yiyu9511/r3-car-mechanical/docs/C30D集成板安装说明.md

# C30D 集成控制板安装说明（电控新方案）

> 更新：2026-11-03。当前电控为 **WHEELTEC C30D 驱控一体板**（实物 V2.3）。
> 模型源文件位于 `models/`，已定位装配位于 `assemblies/`。C30D 属于第一层；第二层放 CAT、雷达和相机。

---

## 1. 模型清单（全部在仓库，不要再用外部路径）

| 零件 | 仓库内文件 | 说明 |
|---|---|---|
| R3 mini 底盘 | `models/R3mini四驱小车底盘（无悬挂）_utf8.stp` | 不动 |
| **C30D 控制板** | `models/C30D-V2.2_2026.04.20.stp` | ★新入库。实物是 V2.3；官方说明 V2.2→V2.3 仅电源电路与 USB 口 TVS 防护差异，**外形尺寸、安装孔完全相同** |
| 鲁班猫 5（上位机） | `models/LubanCat 5-PCB 3D文件.STEP`、`models/LubanCat 5-外壳3D文件-20240911.STEP` | 位于第二层，见 `docs/当前设计.md` |
| **装配验证参考** | `assemblies/c30d_on_chassis.FCStd` | 实际 6 mm 铜柱，四孔中心最大偏差约 **0.00013 mm**；模型几何结果，实物公差未验证 |

## 2. 安装定位（核心结论）

- **安装位 = 底盘中部"树莓派孔组" 58×49mm**（C30D 角孔孔距同为 58×49，四角直接对齐）
- 底盘四角孔坐标（原点=底板中心 Ø20 大孔，**+Y = 车头方向**）：

| 角 | X (mm) | Y (mm) | 底盘模型孔径 |
|---|---|---|---|
| 左后 | -21.04553 | -29.79255 | Ø2.6 |
| 右后 | 36.95447 | -29.79255 | Ø2.6 |
| 左前 | -21.04553 | 19.20745 | Ø2.6 |
| 右前 | 36.95447 | 19.20745 | **Ø3.2** |

- **五金**：M2.5 铜柱 ×4 + M2.5 螺母 + 垫片（C30D 孔为 D3.0，穿 M2.5 螺杆有 0.5mm 间隙，垫片压紧即可）
- **垫高**：当前模型为 6 mm。底板顶面 Z=1.5、PCB 底面 Z=7.5；最低板底元件距底板约 2.3 mm。
- **方向**：验证装配为 0°（模型坐标与底盘同向，**无需旋转**）。若电机走线不顺，可整板转 180°——58×49 矩形中心对称，孔位仍对齐

## 3. FreeCAD 复现步骤（装配同事按此操作）

1. 新建文档，导入 `models/R3mini四驱小车底盘（无悬挂）_utf8.stp`
2. 导入 `models/C30D-V2.2_2026.04.20.stp`
3. 选中 C30D 零件 → 属性 **Placement → Position**：
   - **X = 29.181653，Y = -11.520388，Z = 7.5**。源模型的 PCB 底面为局部 Z=0；铜柱高度为 H 时，**Z = H + 1.5**。
   - Rotation 保持 0
4. 验证：俯视四角孔同心；执行干涉检查，C30D 与底板/轮组无碰撞
5. 对照件：打开 `assemblies/c30d_on_chassis.FCStd`。修改 `Params.standoff_h` 可同时驱动板卡与铜柱高度。

> 生成脚本：`tools/build_current_baseline.py`。报告：`output/current/baseline_checks.json`，包括参数变更和保存后读回校验。

## 4. 电气接线（装配时按此预留走线与开口）

| 连接 | 说明 |
|---|---|
| 电源输入 | 12V 电池 → 电源口（红正黑负，**≤17V，禁反接**） |
| 电机 ×4 | **实车现行接法：A口=右后、B口=左后、C口=左前、D口=右前**。⚠️与官方接线图不同——固件已做端口重映射匹配此接法，**就按此接，不要按官方图改** |
| 串口3（Type-C） | → 鲁班猫 5 USB（ROS 通信，115200） |
| 串口1（Type-C） | 烧录/调试口，留在手能够到的位置 |
| Type-C 5V 供电口 | → 鲁班猫 5 供电（与舵机共 5V/3A 预算） |
| SWD 调试（H2 排针左上 2×2） | pin20=3V3、pin18=GND、pin16=SWDIO(PA13)、pin14=SWCLK(PA14) |
| 使能开关 | 保持可触及（电机总开关，断开则 PWM 归零） |

## 5. 板载功能

C30D 单板集成：STM32F407VET6 主控 + 4×AT8236 电机驱动（单路 ≤1.3A）+ 板载 5V/3A、3.3V 电源（替代稳压模块）+ 4 路编码器接口 + ICM20948 陀螺仪 + OLED + CAN。三件套的功能全部被覆盖，接线大幅减少。

## 6. 安全注意

- 板子**不得直接放金属面**；使用 M2.5 铜柱、合适垫片固定，避免铜柱或紧固件接触非安装区电路。
- 上电前核对电源极性；触碰板子前释放静电
- 电机禁止长时间堵转（单路 ≤1.3A，4 路总 ≤5A）

---

*接线参考：`docs/ref/C30D_V2.3_H2.png`、`docs/ref/C30D_V2.3_SWD.png`。机械复核：`output/current/baseline_checks.json`。*
