yiyu9511/r3-car-mechanical/docs/ref/C30D_V2.3_H2.png

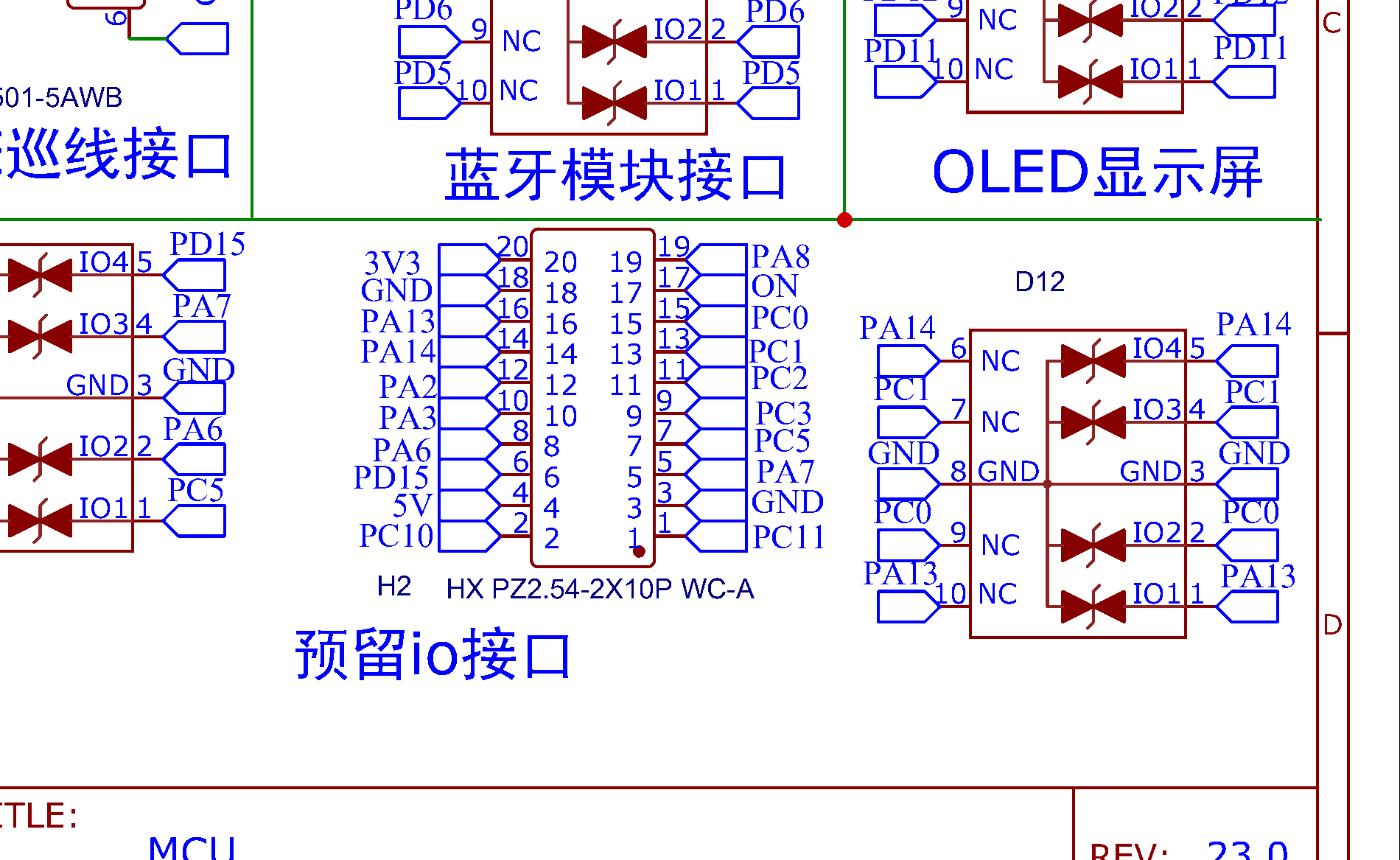
docs/ref/C30D_V2.3_H2.png
