yiyu9511/r3-car-mechanical/docs/ref/C30D_V2.3_SWD.png

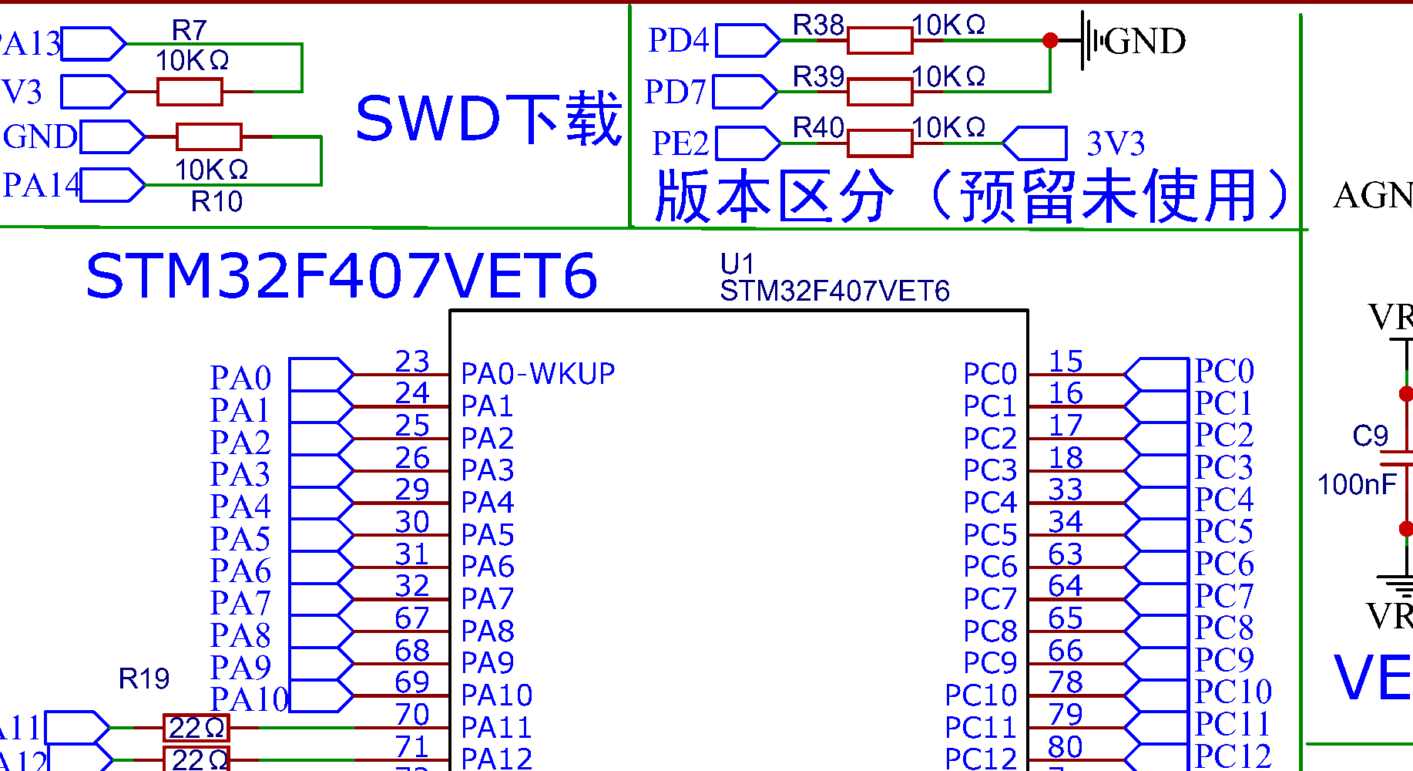
docs/ref/C30D_V2.3_SWD.png
