yiyu9511/r3-car-mechanical/docs/ref/IMX415_V1R1_尺寸图.png

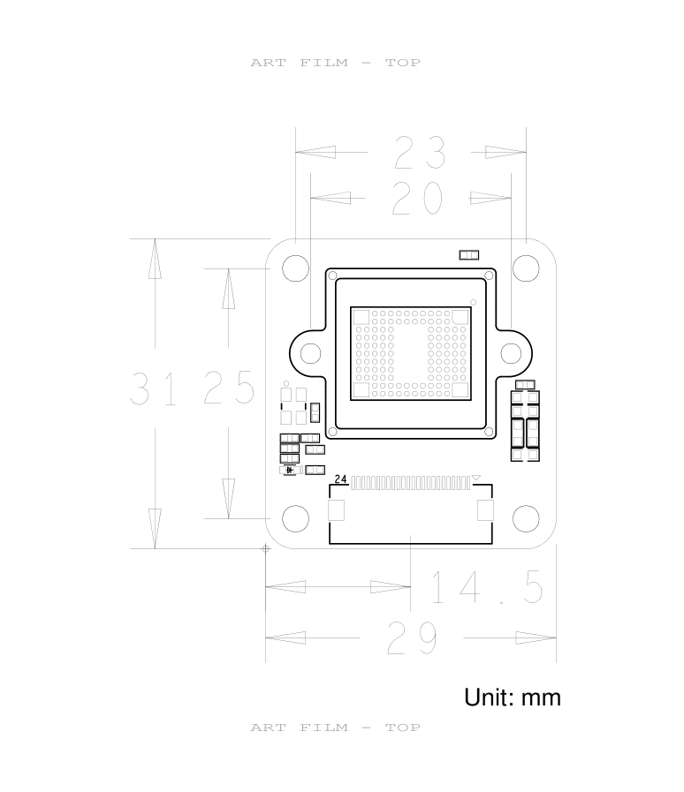
docs/ref/IMX415_V1R1_尺寸图.png
