yiyu9511/r3-car-mechanical/output/current/c30d_on_chassis_iso.png

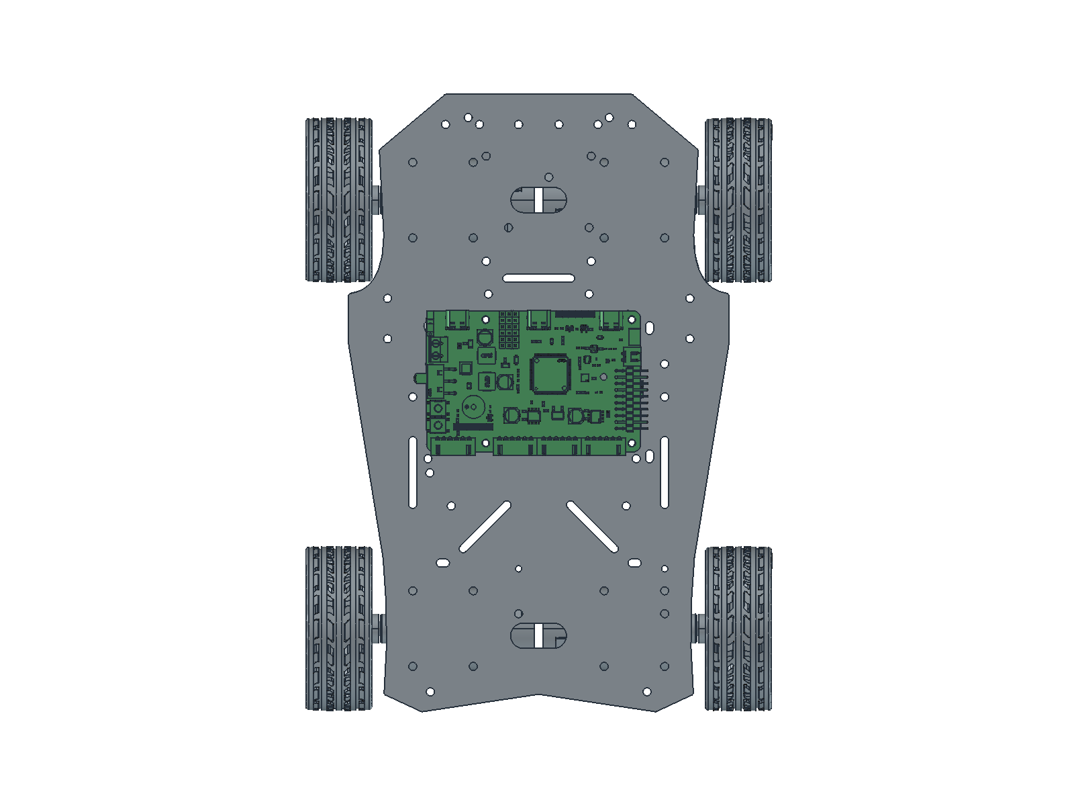
output/current/c30d_on_chassis_iso.png
