yiyu9511/r3-car-mechanical/output/two_layer/cat_mount_underside.png

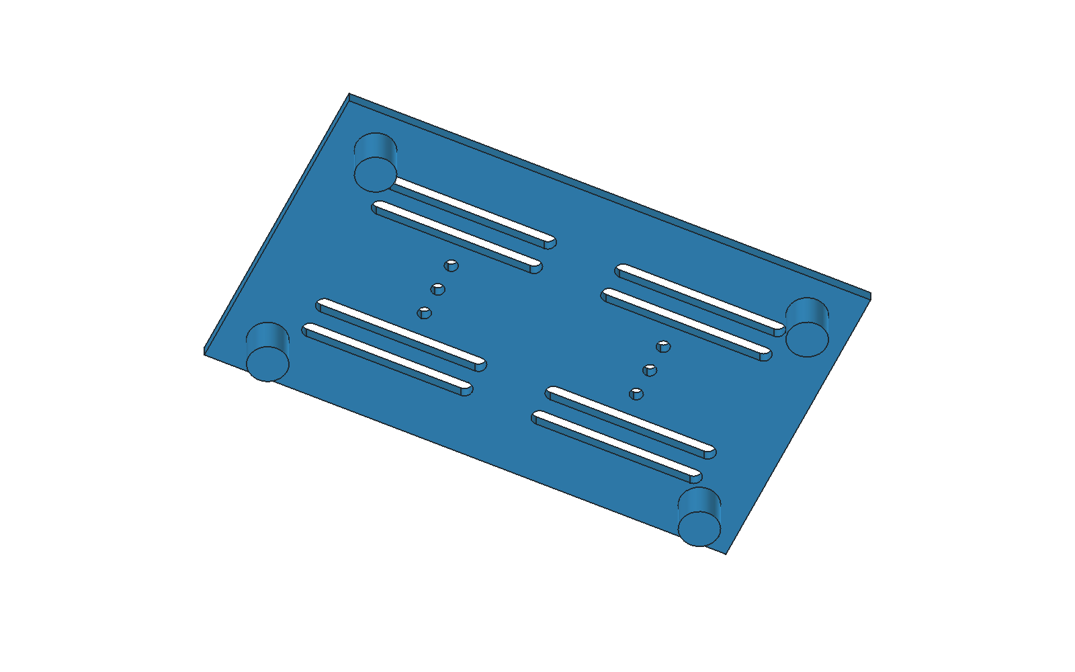
output/two_layer/cat_mount_underside.png
