yiyu9511/r3-car-mechanical/output/two_layer/exploded_iso.png

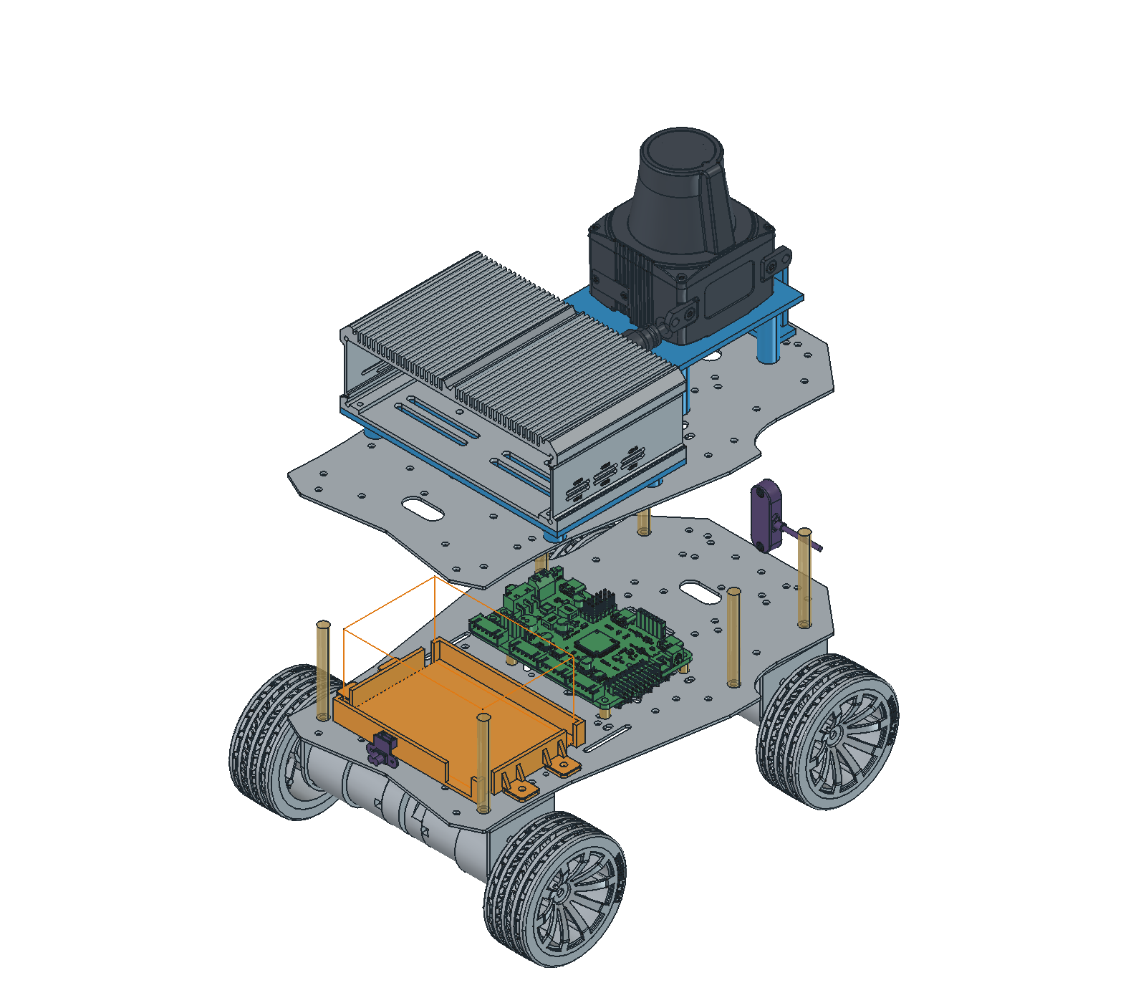
output/two_layer/exploded_iso.png
