yiyu9511/r3-car-mechanical/output/two_layer/layer1_top.png

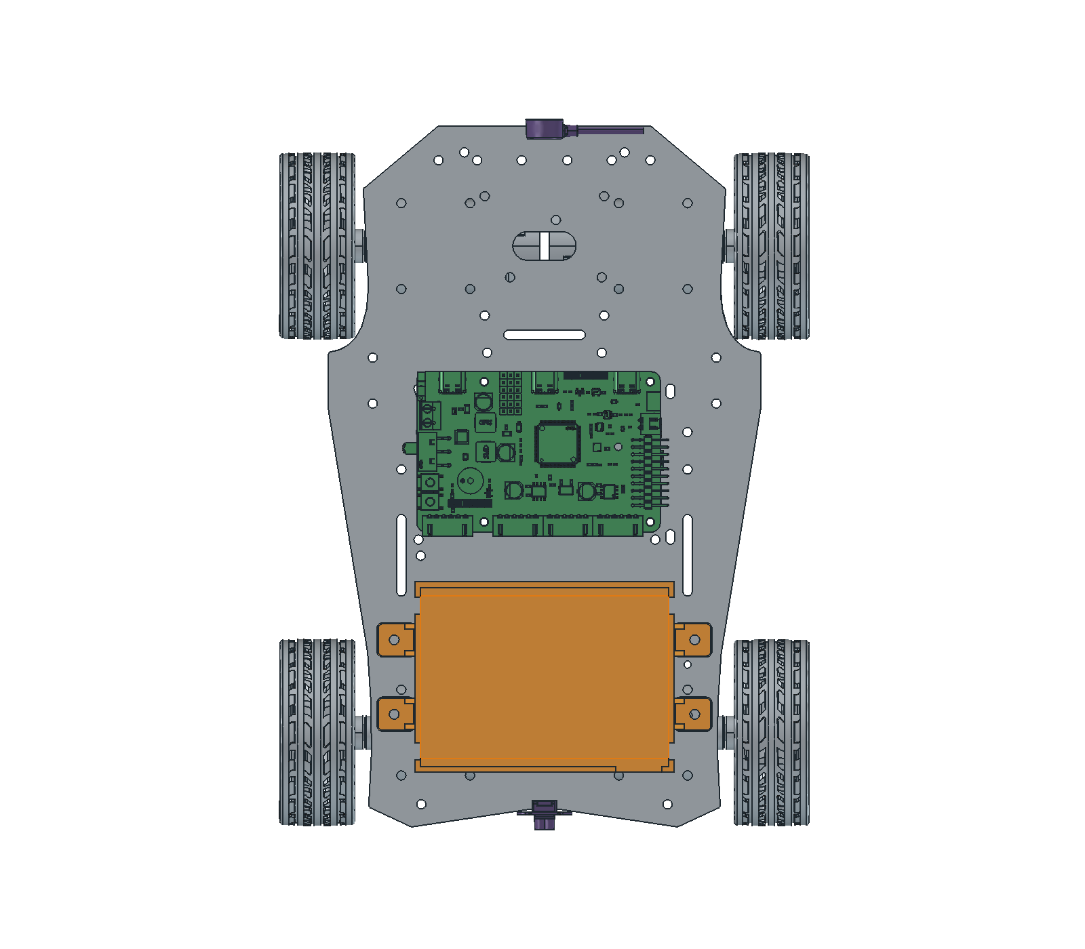
output/two_layer/layer1_top.png
