yiyu9511/r3-car-mechanical/output/two_layer/layer2_top.png

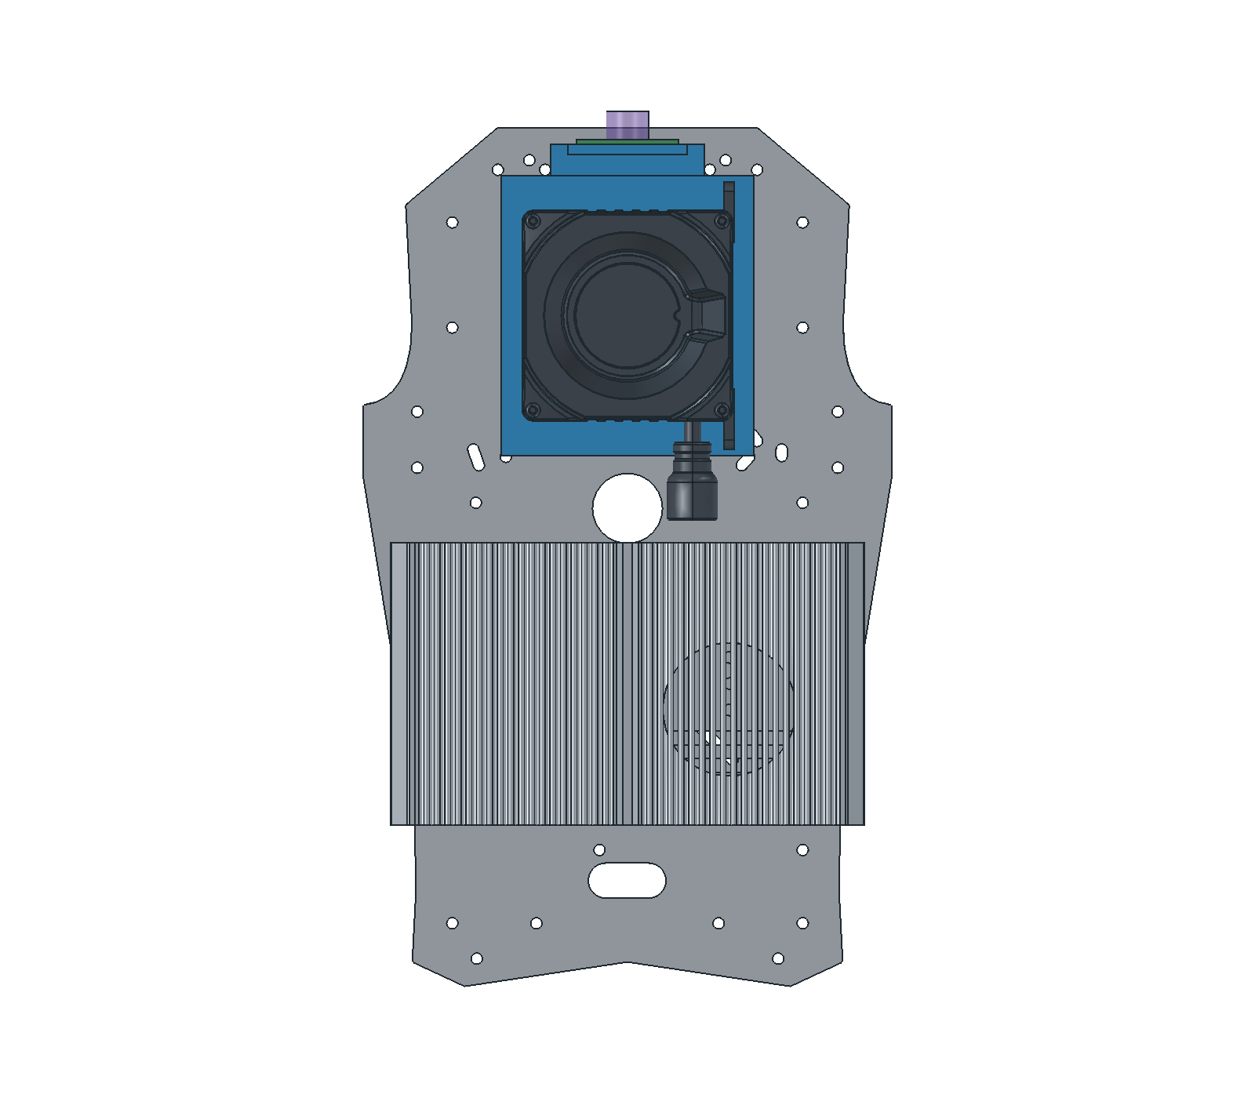
output/two_layer/layer2_top.png
