yiyu9511/r3-car-mechanical/output/two_layer/overview.png

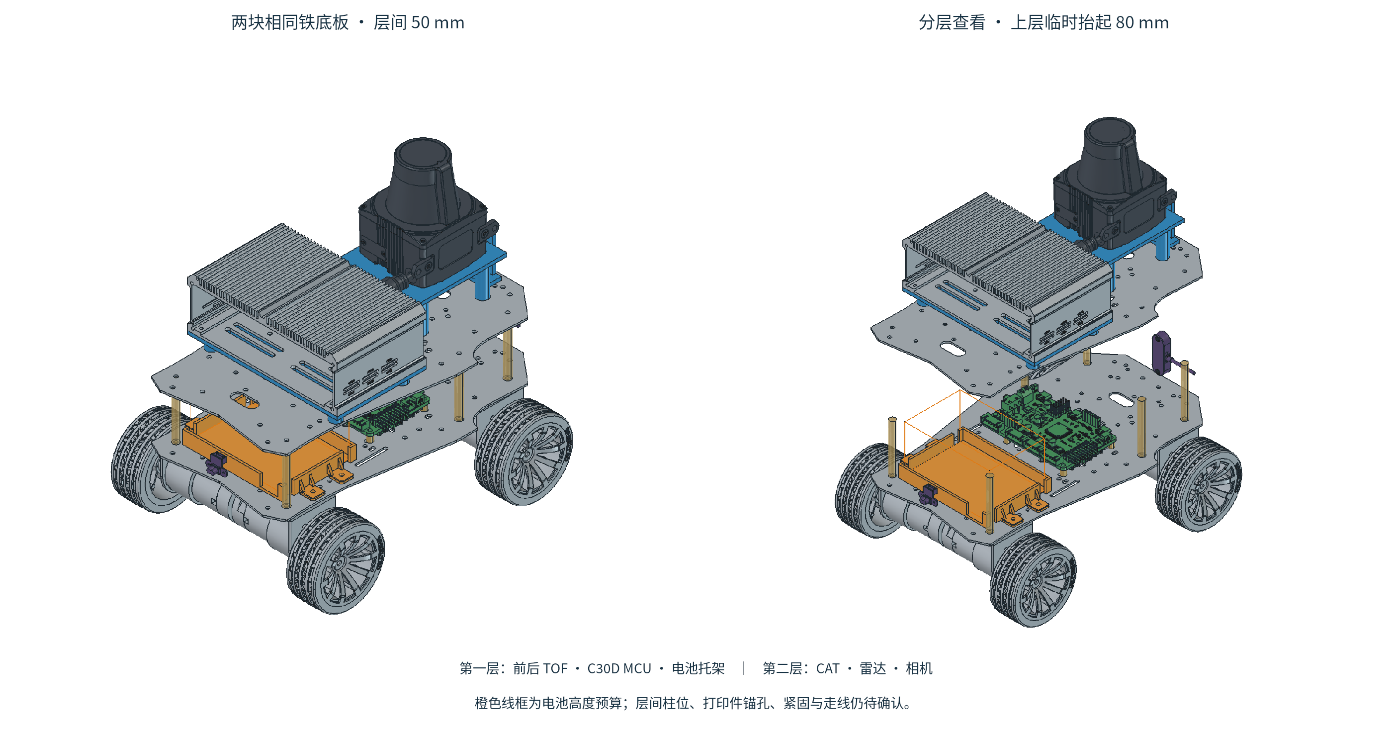
output/two_layer/overview.png
