yiyu9511/r3-car-mechanical/assemblies/c30d_on_chassis.FCStd

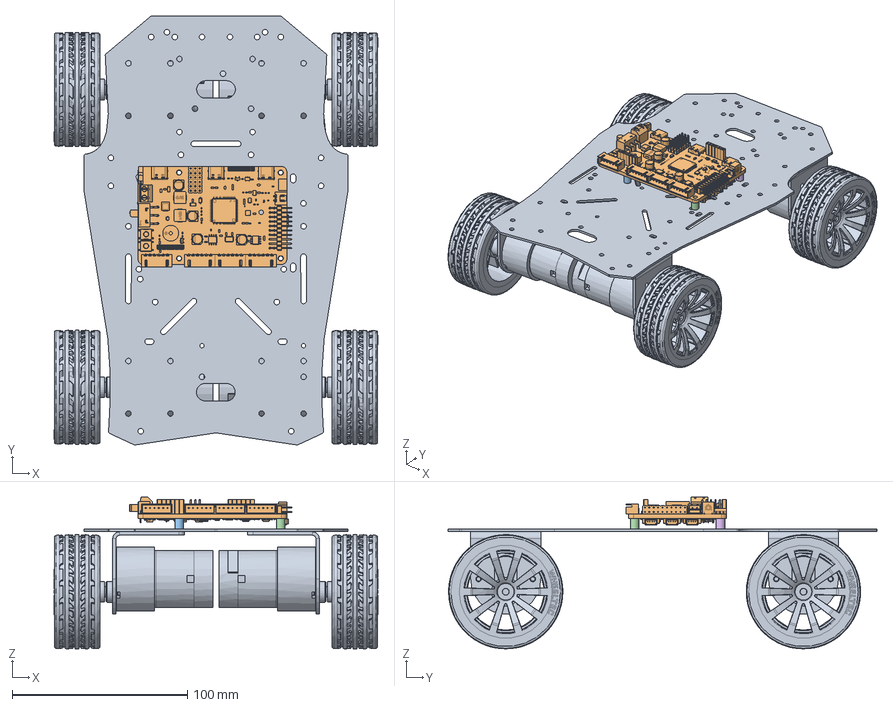
[picture p10: CAD file, 2026-11-03]
assemblies/c30d_on_chassis.FCStd
185.0 x 245.0 x 86.7 mm
R3 mini 底盘
C30D V2.3（使用 V2.2 外形参考）
M2.5×6 铜柱示意 1
M2.5×6 铜柱示意 2
M2.5×6 铜柱示意 3
M2.5×6 铜柱示意 4
