yiyu9511/r3-car-mechanical/models/电池托架参考.step

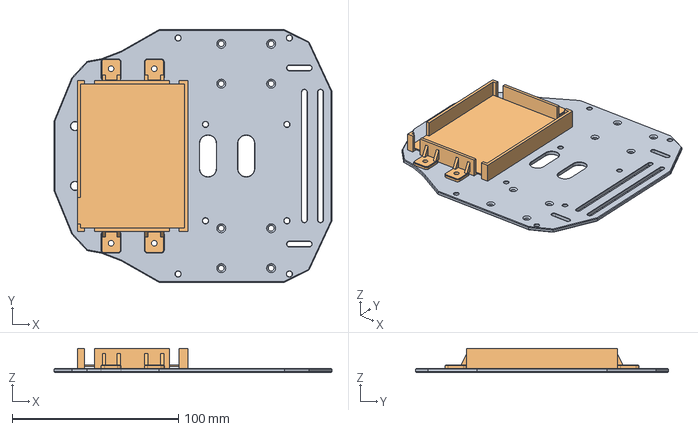
[picture p11: CAD file, 2026-11-03]
models/电池托架参考.step
167.3 x 152.0 x 14.5 mm
