yiyu9511/r3-car-mechanical/assemblies/two_layer.FCStd

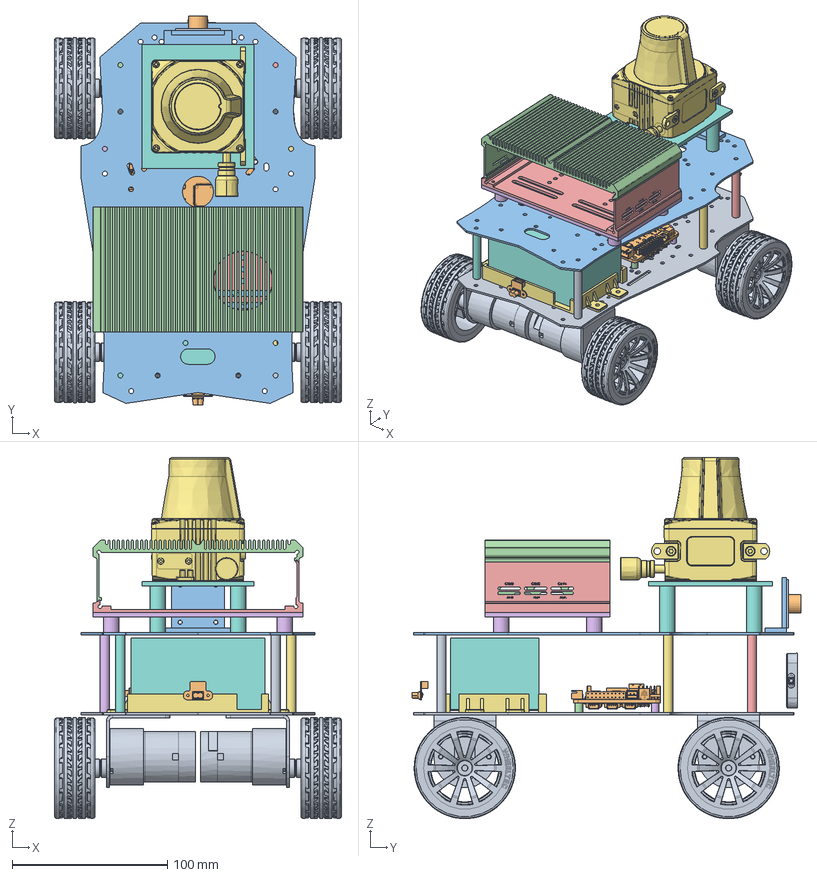
[picture p12: CAD file, 2026-11-03]
assemblies/two_layer.FCStd
185.0 x 250.6 x 232.9 mm
下层原有铁底盘及轮组
C30D MCU · 已确定 6 mm 垫高
MCU 铜柱
MCU 铜柱001
MCU 铜柱002
MCU 铜柱003
用户指定托架 · 内腔与夹持结构保留
电池高度预算框 · 非实物电池模型
TOF-M S 厂家模型
TOF-F2 厂家曲面参考 · 非闭合实体
第二块相同铁底板 · 原轮廓 / 原孔型
CAT 金属外壳
CAT 金属外壳001
CAT 贴壳托板 + 四个局部落脚 · 未开底盘锚孔
雷达机身与扫描头（原弯曲线缆另列）
雷达转接架占位 · 保持原机身 · 紧固与锚孔未定
IMX415 V1R1 板轮廓/孔位 · 厚度未实测
镜头包络占位 · 尺寸不是加工依据
相机支架概念 · 无铁板锚孔
层间铜柱候选 1（未确认可用孔）
层间铜柱候选 2（未确认可用孔）
层间铜柱候选 3（未确认可用孔）
层间铜柱候选 4（未确认可用孔）
层间铜柱候选 5（未确认可用孔）
层间铜柱候选 6（未确认可用孔）
