yiyu9511/r3-car-mechanical/models/C30D-V2.2_2026.04.20.stp

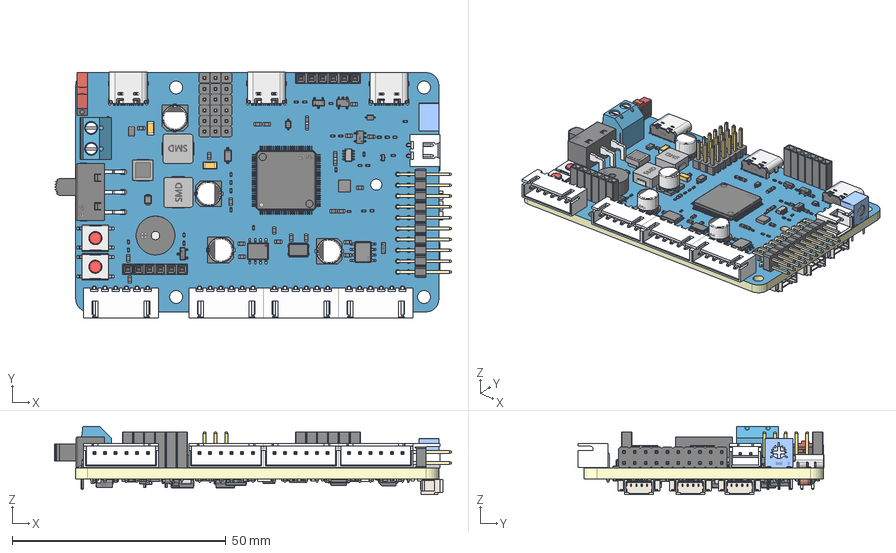
[picture p13: CAD file, 2026-11-03]
models/C30D-V2.2_2026.04.20.stp
92.9 x 57.5 x 16.0 mm
Board~zoGU_1
TopCopper~zoGU_1
BottomCopper~zoGU_1
TopFpcStiffener~zoGU_1
BottomFpcStiffener~zoGU_1
WDFN-5_L3.3-W3.3-P0.65-BL~WDFN-5_L3.3-W3.3-P0.65-BL~iKOY_1 x 2
C0603~0603~H7io_1 x 66
USON-10_L2.5-W1.0-P0.50-BL~USON-10_L2.5-W1.0-H0.6-P0.50~hjPK_1 x 11
CONN-SMD_GP01-1250WRS-4P~CONN-SMD_GP01-1250WRS-4P~h4bH_1 x 3
R0603~R0603~q9do_1 x 32
SOT-23-5_L3.0-W1.7-P0.95-LS2.8-BR~SOT-23-5_L3.0-W1.9-P0.95-BL~efmv_1
SOIC-8_L5.0-W4.0-P1.27-LS6.0-BL-EP~SOIC-8_L5.0-W4.0-P1.27-LS6.0-BL-EP~TPw5_1 x 2
4148~SOD-80C_L3.3-W1.5-H1.5-RD~f0Kv_1
SMB_L4.6-W3.6-LS5.3-RD~SMB_L4.6-W3.6-LS5.3-RD~4kkn_1 x 4
QFN-24_L4.0-W4.0-P0.50-BL-EP2.5~QFN-24_L4.0-W4.0-P0.50-BL-EP2.5~hbPG_1 x 2
R0603~R2512_L6.3-W3.2-H0.6~DNXC_1 x 2
R2512~R2512_L6.3-W3.2-H0.6~DNXC_1 x 2
C1206~C1206_L3.2-W1.6-H1.3~i1Ai_1 x 4
ESOP-8_L4.9-W3.9-P1.27-LS6.0-BL-EP~ESOP-8_L4.9-W3.9-P1.27-LS6.0-BL-EP-A~smAH_1 x 2
CONN-SMD_2.54-2PWT~CONN-SMD_2.54-2PWTB~Tr5w_1
SOT-23-3_L2.9-W1.6-P1.90-LS2.8-BR~SOT-23-3~imgh_1 x 3
ESOP-8_L4.9-W3.9-P1.27-LS6.0-BL-EP~ESOP-8_L4.9-W3.9-P1.27-LS6.0-BL-EP3.3~G8WZ_1 x 2
SOIC-8_L4.9-W3.9-P1.27-LS6.0-BL~SOIC-8_L4.9-W3.9-P1.27-LS6.0-BL-EP-1~XG5v_1
SOD-123_L2.7-W1.6-LS3.7-RD~SOD-123_L2.7-W1.6-LS3.7-RD-1~rkkE_1
SOD-123FL_L2.7-W1.8-LS3.8-RD~SOD-123FL_L2.7-W1.8-LS3.8-RD-1~IUjj_1 x 2
L0805~L0805_L2.0-W1.3-H0.9~AZev_1
SOT-23-5_L3.0-W1.7-P0.95-LS2.8-BR~SOT-23-5_L2.9-W1.6-P0.95-LS2.8-BL~JfRL_1 x 3
SMB_L4.3-W3.6-LS5.3-RD~SMB_L4.3-W3.6-LS5.4-R-RD~8GdQ_1
FILTER-SMD_4P-L5.0-W4.8-TL~FILTER-SMD_4P-L5.0-W4.8-TL~e4g5_1
SOT-23_L2.9-W1.3-P1.90-LS2.4-BR~SOT-23_L2.9-W1.3-P1.90-LS2.4-BR-1~AAka_1_1
HDR-TH_2P-P2.50_XY-XH2.54-2A21~HDR-TH_2P-P2.50_XY-XH2.54-2A21~xBt2_1
2_10P弯排针~HDR-TH_PZ254R-12-20P-RD~Effy_1
KEY-SMD_4P-L6.2-W6.2-P4.00-LS6.8~KEY-SMD_4P-L6.0-W6.0-P4.50-LS8.6_TS6625A4P~JGtd_1 x 2
ICM20948-QFN-24~QFN-24_L2.8-W2.8-BMS003~Jafe_1
F0805~F0805_L2.1-W1.4-H0.8~WA51_1
HDR-M-2.54_1X3~HDR-M-2.54_1x3~QQ3y_1 x 6
CONN-TH_6P-P2.50_B6B-XH-A-LF-SN~HDR-F-2.54_1x6~mopP_1 x 2
IND-SMD_L7.3-W6.8~IND-SMD_L7.3-W6.8-H3.0~fGpv_1 x 2
SOT-23-8_L3.0-W1.7-P0.65-LS2.8-BL~TSOT-23-8_L2.9-W1.6-P0.65-LS2.8-TL~tMWu_1
CAP-SMD_BD6.3-L6.6-W6.6-RD~CAP-SMD_BD6.3-L6.6-W6.6-FD_EFVM063ADA220M0640~GzIP_1 x 4
OSC-SMD_L5.0-W3.2~OSC-SMD_L5.0-W3.2-H1.4~kKbf_1
USB-C-SMD_TYPE-C-USB-17~USB-C-SMD_TYPE-C-USB-17~E8VL_1 x 3
RES-ADJ-TH_3362S~RES-ADJ-TH_3362S~l5SZ_1
CONN-TH_6P-P2.50_X8821WR-06S-N2SN~CONN-TH_6P-P2.50_X8821WR-06S-N2SN~kmu8_1 x 4
SW-TH_BSI-10~SW-TH_BSI-10-L10.0-W2.5-H6.4-P2.54~bBl8_1
SOD-323_L1.8-W1.3-LS2.5-RD~SOD-323_L1.8-W1.3-LS2.5-RD~fWDH_1 x 2
BEEP-TH_BD9.1-P5.00-D0.6-L-FD~BEEP-TH_BD9.1-H4.2-P5.00~JwZv_1
LQFP-100_L14.0-W14.0-P0.50-LS16.0-TL~LQFP-100_L14.0-W14.0-P0.50-LS16.0-TL~bl79_1
电源拨动开关~SW-TH_SS-12M12G5~T43r_1
508蓝色端子~CONN-TH_2P-P5.00_KF301-5.0-2P~bX5P_1
