yiyu9511/r3-car-mechanical/models/TOFSense_M_S_Appearance_V1.0.step

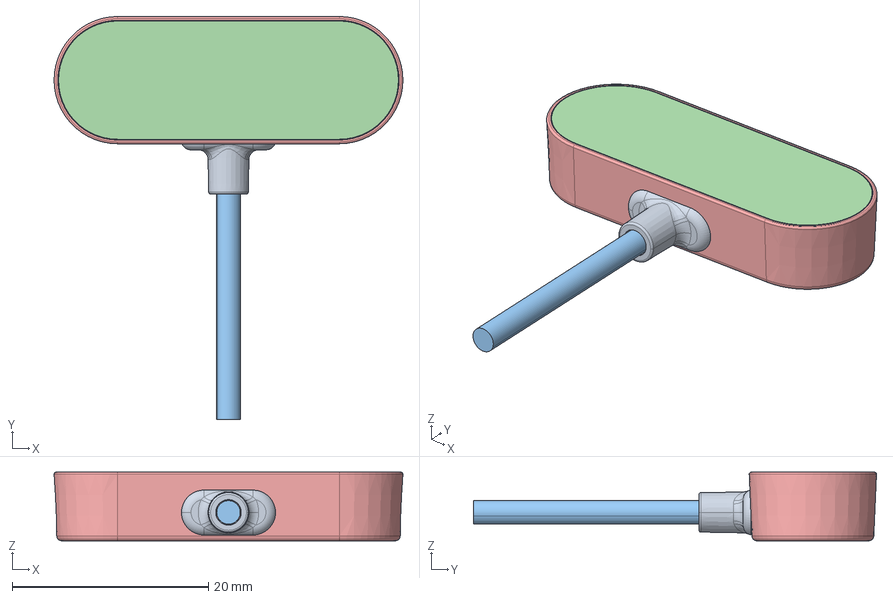
[picture p14: CAD file, 2026-10-22]
models/TOFSense_M_S_Appearance_V1.0.step
35.6 x 41.1 x 7.00 mm
TOFSense-M S
TOFSense-M S001
TOFSense-M S002
TOFSense-M S003
TOFSense-M S004
TOFSense-M S005
