yiyu9511/r3-car-mechanical/models/LubanCat 5-PCB 3D文件.STEP

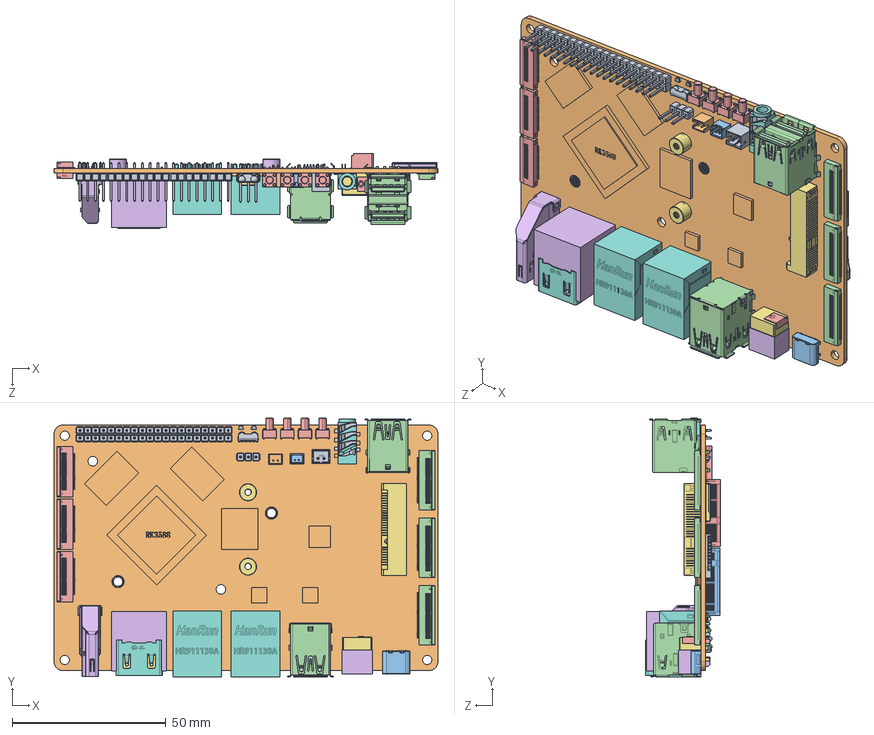
[picture p15: CAD file, 2026-10-22]
models/LubanCat 5-PCB 3D文件.STEP
125.0 x 84.2 x 24.3 mm
鲁班猫5板图
User Library-USB-TYPE-C20
USB3.0+2.0卷边座子 零件
User Library-DC044A
20X2
User Library-pj-393-8_PJ-393-8_1
User Library-pj-393-8_PJ-393-8_2 x 4
User Library-pj-393-8_PJ-393-8_4 x 3
零件4^User Library-pj-393-8
USB2.0双层卷边 零件
边三脚侧插侧按按键254gf x 4
72r3759_2007435
HR911130A x 2
IRM-v838M3 红外贴片
ZH 2P 插件1.5MM
1.25X2pin
3PIN
PCIE-52P56H
A2001WV-2P
x05a20l30t x 3
x05a20l24t x 6
双层HDMI块
HDMI x 2
User Library-Micro_SD_Socket_Push-push
SIM卡mini
M.2-4+29针角 4.75高
M.2-11+22针角 4.8高
贴片螺柱M3x3.5 x 2
贴片螺柱M2x3 x 2
侧贴片红灯 x 2
