yiyu9511/r3-car-mechanical/models/TOFSense_F2_Mini_Appearance_V1.0.step

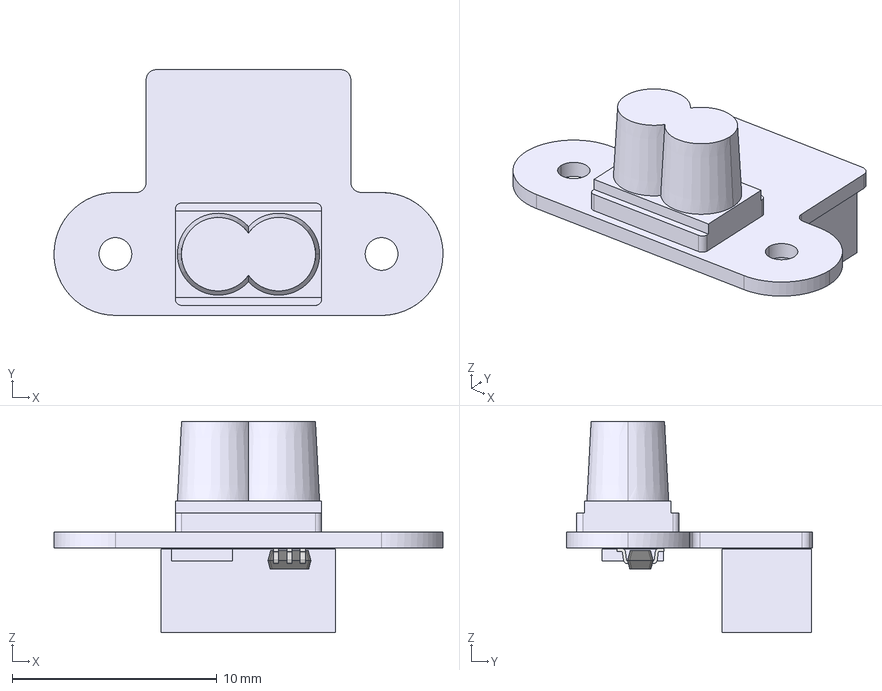
[picture p16: CAD file, 2026-10-22]
models/TOFSense_F2_Mini_Appearance_V1.0.step
19.0 x 12.0 x 10.3 mm
TOFSense-F2 Mini
TOFSense-F2 Mini001
TOFSense-F2 Mini002
TOFSense-F2 Mini003
TOFSense-F2 Mini004
TOFSense-F2 Mini005
TOFSense-F2 Mini006
TOFSense-F2 Mini007
TOFSense-F2 Mini008
TOFSense-F2 Mini009
TOFSense-F2 Mini010
TOFSense-F2 Mini011
TOFSense-F2 Mini012
TOFSense-F2 Mini013
TOFSense-F2 Mini014
TOFSense-F2 Mini015
TOFSense-F2 Mini016
TOFSense-F2 Mini017
TOFSense-F2 Mini018
TOFSense-F2 Mini019
TOFSense-F2 Mini020
TOFSense-F2 Mini021
TOFSense-F2 Mini022
TOFSense-F2 Mini023
TOFSense-F2 Mini024
TOFSense-F2 Mini025
TOFSense-F2 Mini026
TOFSense-F2 Mini027
TOFSense-F2 Mini028
TOFSense-F2 Mini029
TOFSense-F2 Mini030
TOFSense-F2 Mini031
TOFSense-F2 Mini032
TOFSense-F2 Mini033
TOFSense-F2 Mini034
TOFSense-F2 Mini035
TOFSense-F2 Mini036
