yiyu9511/r3-car-mechanical/models/R3mini四驱小车底盘（无悬挂）_utf8.stp

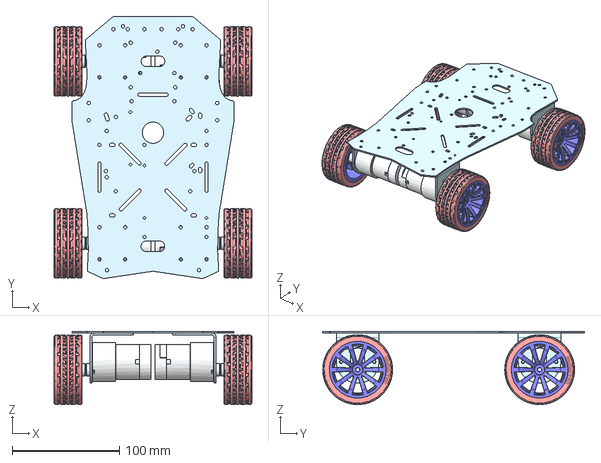
[picture p17: CAD file, 2026-10-22]
models/R3mini四驱小车底盘（无悬挂）_utf8.stp
185.0 x 245.0 x 68.4 mm
底板_4
四驱车轮组 x 4
