yiyu9511/r3-car-mechanical/models/单线雷达总装.STEP

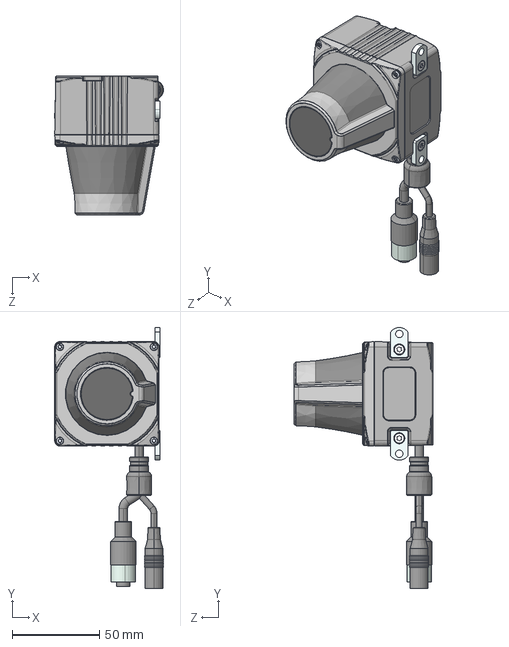
[picture p18: CAD file, 2026-10-22]
models/单线雷达总装.STEP
62.6 x 149.9 x 79.9 mm
