yiyu9511/r3-car-mechanical/(list of files, cad)

Other CAD files:
models/LubanCat 5-外壳3D文件-20240911.STEP
