yiyu9511/r3-car-mechanical/output/two_layer/assembled_iso.png

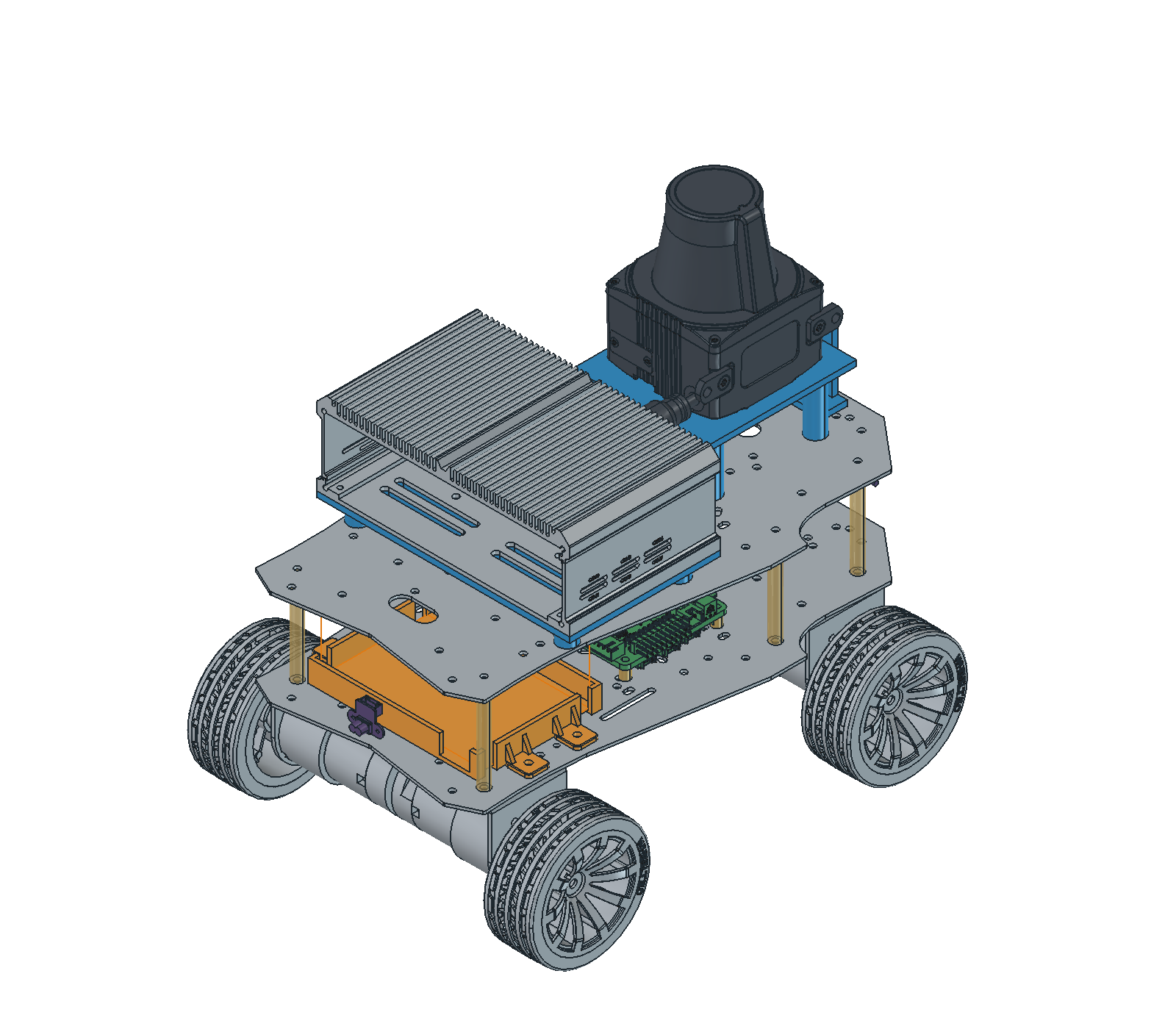
output/two_layer/assembled_iso.png
