yiyu9511/r3-car-mechanical/(commit log)

2026-10-19 两层结构 v16 定案：方案B（相机二层）+ 全打印转接件
    - 成品双板不动刀，6 个打印件全部锚定现成孔
    - LubanCat 外壳 M2.5×6 单头铜柱垫高，转接板纯矩形 10 锚点
    - 设备塔 96×73 矩形 8 锚点：TB6612(18,54)/F407(10,52)/RT8279(-34,54)
    - 雷达 24mm 立柱架高过壳顶；TOF-F2 前脸贴墙 M1.4 自攻固定
    - 电池前移 (0,-64) 磁吸；渲染链路 pyvista（render_asm.py）
    [F407mini_外形孔位.dxf, LubanCat转接板.FCStd, LubanCat转接板.stl, TOF后支架.FCStd, TOF后支架.stl, test1_B_相机二层.FCStd, 前传感器支架B.FCStd, 前传感器支架B.stl]
2026-10-19 存档：五金清单与装配/拆装指南
2026-10-19 全部立柱改铜柱：塔 v9 纯平板 + 雷达板无立柱
    - 设备塔：打印柱废除，F407=M3x18 / TB6612=M3x5 / RT8279=M3x4 双通铜柱，
    底座底面沉头孔藏螺丝头；板卡全部机牙螺丝，不限拆装
    - 雷达转接板：24mm 打印立柱废除，改 M2.5x25 单头铜柱 x4
    - 打印包 6 件全部为无铜柱纯打印件；BOM 同步
    [01_设备塔.stl, 02_前传感器支架B.stl, 03_相机支架L2.stl, 04_TOF后支架.stl, 05_LubanCat转接板.stl, 06_雷达转接板_无立柱.stl, test1_B_相机二层.FCStd, 设备塔.FCStd]
2026-10-19 渲染与README同步铜柱化定案（1100 时间戳总览图）
2026-10-19 雷达整机直坐+侧耳固定：废除雷达铜柱，转接板加侧墙，整体后移6mm避相机
    [06_雷达转接板_侧墙夹耳.stl, 06_雷达转接板_无立柱.stl, radar_full.stl, test1_B_相机二层.FCStd, 雷达转接板.FCStd, 雷达转接板.stl]
2026-10-19 雷达转90耳朝后+cat转180接口朝后+相机并入雷达板+转接板中心走线孔
    - 修复雷达底座与外壳 5mm 重叠（方向算反），净距 6.3mm
    - 雷达整机 Rz(-90) 耳/盲区朝车尾；cat Rz(180) 主接口排朝车尾全可用
    - 雷达转接板 v7：耳挡墙x2（各1颗M3x12）+ 前缘相机墙一体，相机支架L2退役
    - LubanCat转接板加 Ø22 中心孔对位底板走线孔；打印件减为 5 件
    [03_TOF后支架.stl, 03_相机支架L2.stl, 04_LubanCat转接板_带中心孔.stl, 05_LubanCat转接板.stl, 05_雷达转接板_耳挡墙相机一体.stl, 06_雷达转接板_侧墙夹耳.stl, LubanCat转接板.FCStd, LubanCat转接板.stl]
2026-10-19 文档清点：打印件定稿 5 件、雷达耳螺栓 2 颗、删退役相机支架条目
2026-10-19 雷达固定改底面直锁：4xM4 板底沉头 + 两片独立耳墙辅助
    [05_雷达转接板_底孔耳墙相机一体.stl, 05_雷达转接板_耳挡墙相机一体.stl, test1_B_相机二层.FCStd, 雷达转接板.FCStd, 雷达转接板.stl]
2026-10-19 TOF后支架 v4：按 F2 实测模型重做前脸开孔——单圆角通窗覆盖凸环+中央锥台，导孔只留下方2个并修正Z偏1.5；新增干涉检查脚本与1:1墙面模板
    [TOF后支架.FCStd, TOF后支架.stl, f2mini_model.stl, test1_B_相机二层.FCStd]
2026-10-19 TOF后支架 v6：按 STEP 真实孔位重做——安装凸台 Ø6/Ø1.6孔 @(±6.5,z7.5) 沉台 Ø7.2 让位，中央通窗只罩光学锥台，M2x8 自攻
    [TOF后支架.FCStd, TOF后支架.stl]
2026-10-19 TOF后支架 v7：射线探测确认前脸是平板（Ø6 只是 0.2mm 台阶非凸台），去掉多余 Ø7.2 沉台，只留 2xØ2.2 过孔
    [TOF后支架.FCStd, TOF后支架.stl]
2026-10-19 TOF后支架 v8：按官方图纸定孔——2-M1.6@13.0间距，过孔改Ø1.8配M1.6x4机牙；图纸各尺寸与模型实测交叉验证一致
    [TOF后支架.FCStd, TOF后支架.stl]
2026-10-19 五金清单重整：按用途分组、补层间铜柱12颗M3x6、删退役相机架2颗锚定、TOF-F2定稿M1.6x4
2026-10-21 新增孔位图适配教程：外部几何投影工作流 + 铜柱孔径表 + 三道验证关
2026-10-21 F407 STEP 生成器：从嘉立创 DXF（外形+孔位+排针）参数化建板，输出 models/F407Mini开发板_外形孔位.step
2026-10-22 纳入 models 源模型（含 LubanCat/雷达大件）到 git 用于远程同步；加入 self_test 建模练习与孔位探测脚本
    [E351S电池(客户图）.stp, F407Mini_preview.stl, F407Mini开发板_外形孔位.step, LubanCat 5-PCB 3D文件.STEP, LubanCat 5-外壳3D文件-20240911.STEP, R3mini四驱小车底盘（无悬挂）_utf8.stp, RT8279稳压模块PCB模型文件.step, TB6612四路驱动稳压模块（D24A）_utf8.stp]
2026-10-27 备份：CAT支架 P2S 打印配置工程（Bambu Studio 调好的 PETG 参数版：4墙/40%陀螺体/EF补偿0.2）
    [cat_bracket_configured.3mf]
2026-11-03 CAT支架 v7 定版：参数化建模脚本 + FCStd/STEP/STL/3MF + GUI 建模教学
    - 结构：3mm 底板贴小车底盘（10 锚孔）+ 2 条跑道形肋排 17mm 撑起 CAT，总垫高 20mm
    - 锚孔 10 点（全部底盘实测 M3 孔）：(±60,27.61)(±60,11.61)(±20,29.35)(±50,-11.46)(±44,-35.97)
    - CAT 固定：肋顶 6 个 φ2.5×10 自攻盲孔（外壳下主体实测孔位 -25.86/29.14 × 7.5/0/-7.5）
    - 锚孔圆形沉孔 φ6.5×2.0（埋 M3 螺母，留 1.0mm 承压 web）
    - 校验：圆柱面分布全命中、11 张草图全约束、参数化回归通过、约 49.8g
    [cat_bracket.3mf, cat_bracket.FCStd, cat_bracket.step, cat_bracket.stl]
2026-11-03 C30D 一体化板装配与孔位数据：装配体 + 底盘/鲁班猫孔位 JSON + SWD 接线参考图
    [c30d_on_chassis.FCStd]
2026-11-03 docs: C30D集成板安装说明入库，旧三件套方案作废
    - 新增 docs/C30D集成板安装说明.md：58x49直装定位、Placement复现值(X29.18,Y-11.52,Z5.81)、电气接线(实车电机接法)、安全注意
    - 装配路线图.md 顶部加作废横幅：F407 Mini+TB6612+稳压模块方案废弃，以新文档为准
    - models/ 入库 C30D-V2.2_2026.04.20.stp（实物V2.3，官方说明外形孔位相同）
    - 对照件 models/c30d_on_chassis.FCStd 已在库（4孔对齐误差0.000mm）
    [C30D-V2.2_2026.04.20.stp]
2026-11-03 feat: 建立双层钢底板装配并清理过期方案
    采用两块相同铁底板和可调 50 mm 层间高度：第一层为前后 TOF、
    C30D MCU 与电池托架，第二层为 CAT、雷达和相机。
    重建实际 6 mm 垫高的 C30D 基线；CAT 连接件采用贴壳托板、
    四个局部落脚及 8 条贯通通风槽。保留用户指定的电池托架参考。
    同步当前文档、生成/校验脚本、FCStd 和预览，删除过期装配、
    旧电控和电池模型、打印包及其配套数据。
    验证：脚本语法和文档链接检查通过；两份 FCStd 保存后读回正常；
    几何校验 25 项通过；253 对对象检查未发现体积重叠。
    仍为布局/结构概念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
    [01_设备塔.stl, 02_前传感器支架B.stl, 03_TOF后支架.stl, 04_LubanCat转接板_带中心孔.stl, 05_雷达转接板_底孔耳墙相机一体.stl, E351S电池(客户图）.stp, F407Mini_preview.stl, F407Mini开发板_外形孔位.step]
